kwakeham/AnalogCycleComputer/kicad/Analogue/Step/BMD-350-A-R.step

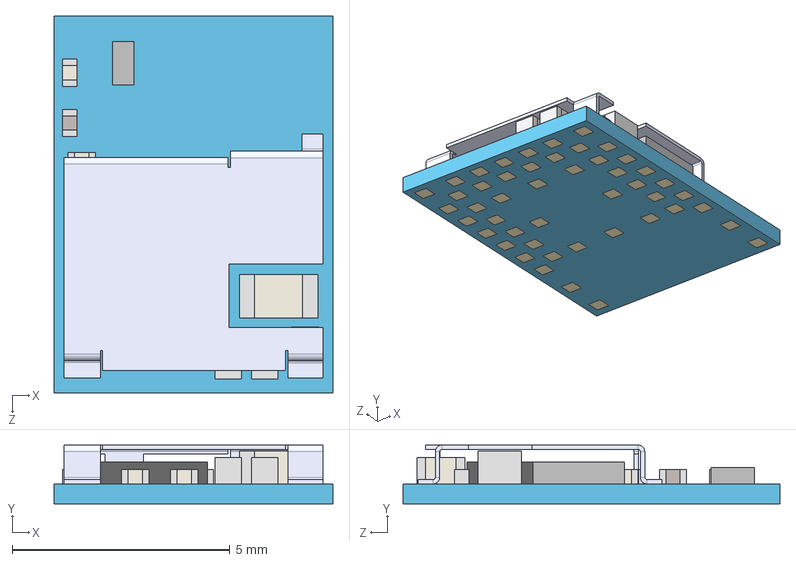
[picture p1: CAD file, 2022-01-26]
kicad/Analogue/Step/BMD-350-A-R.step
6.40 x 1.35 x 8.65 mm
BMD-350-A-R board
BMD-350 cip
