kwakeham/AnalogCycleComputer/kicad/Analogue/Step/SAM_AP214.STEP

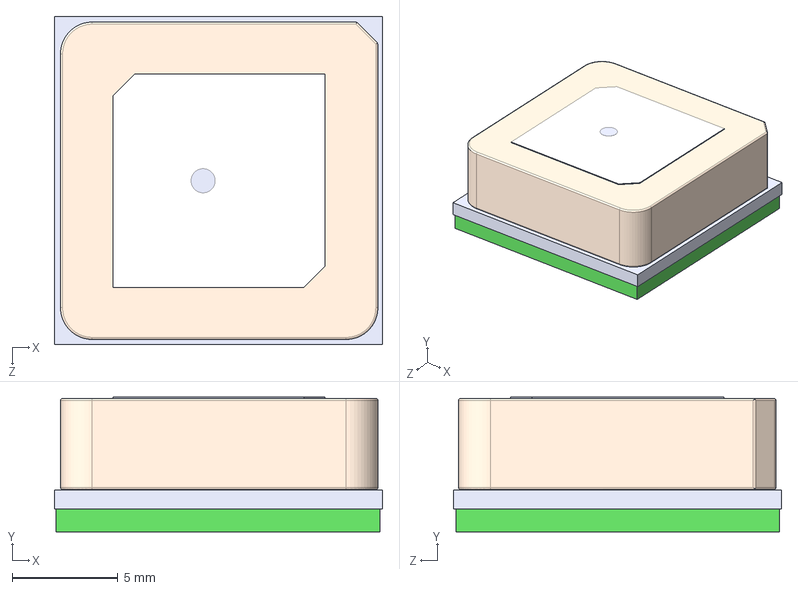
[picture p2: CAD file, 2022-01-25]
kicad/Analogue/Step/SAM_AP214.STEP
15.5 x 6.38 x 15.5 mm
Sam cavity
SAM PCB
SAM ANT
