kwakeham/AnalogCycleComputer/kicad/Analogue/Analogue.kicad_pcb

## KiCad design kicad/Analogue/Analogue.kicad_pcb (2022-01-26)

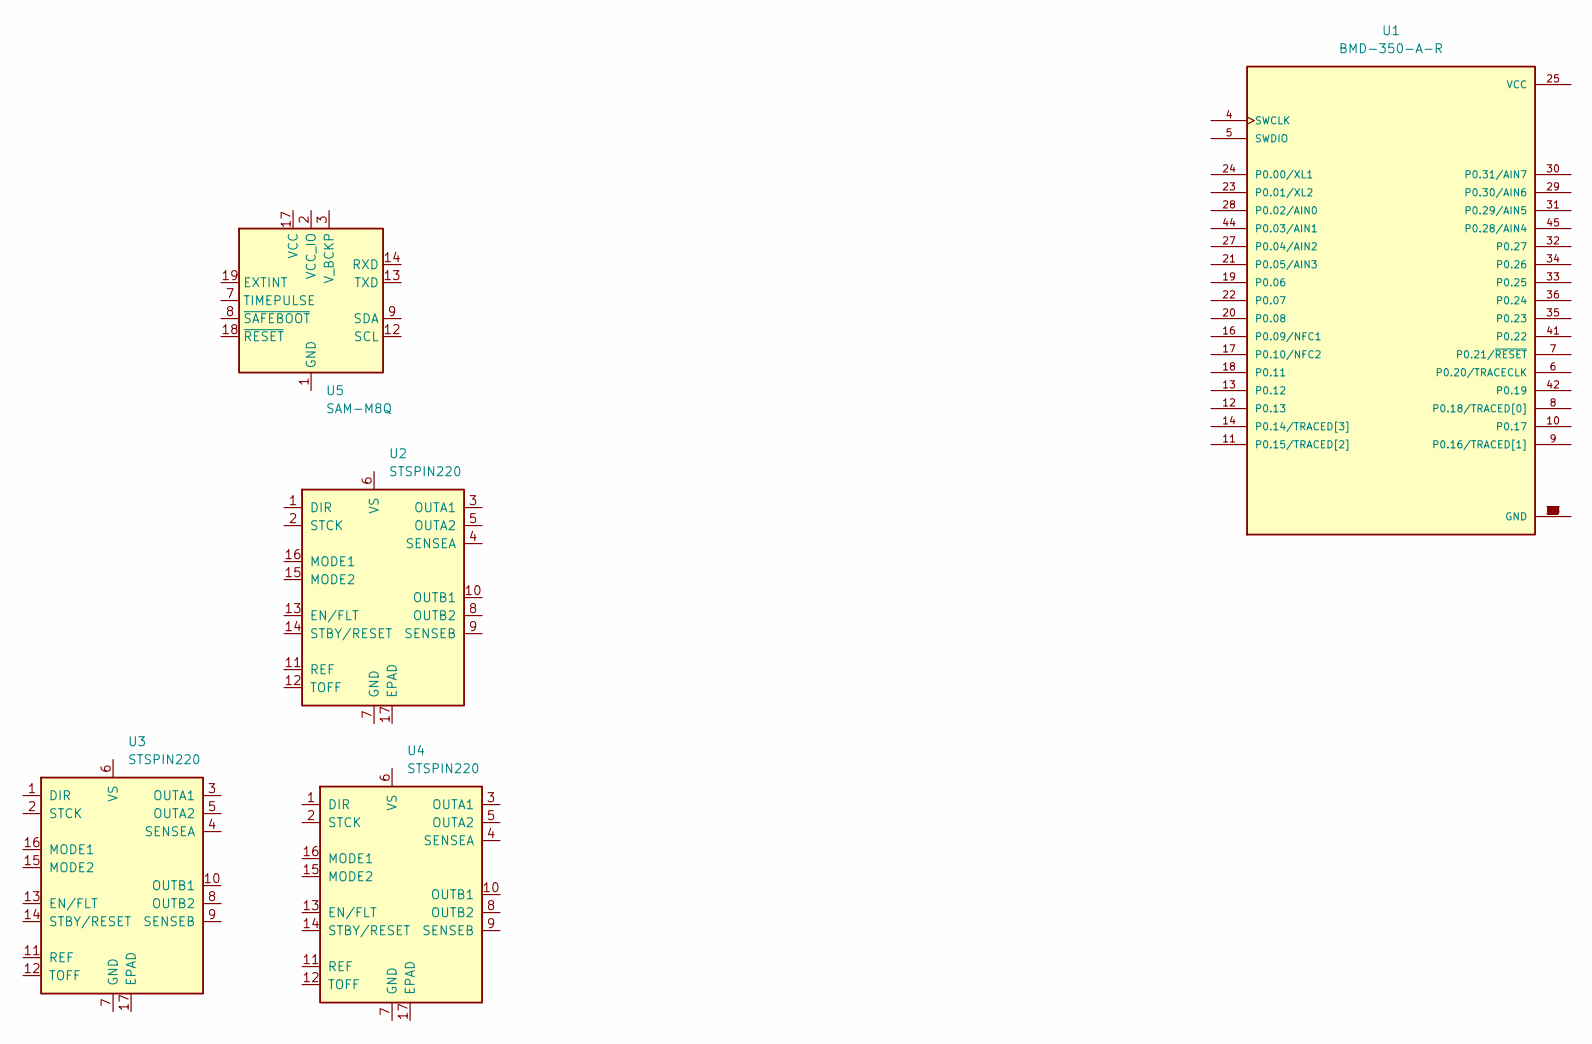
[picture p3: schematic Analogue.kicad_sch]

Parts:
U1: BMD-350-A-R; XCVR_BMD-350-A-R; PARTREV 2.0
U2, U3, U4: STSPIN220; VQFN-16-1EP_3x3mm_P0.5mm_EP1.8x1.8mm
U5: SAM-M8Q; ublox_SAM-M8Q

Connections:
unnamed: U1.1 (GND), U1.2 (GND), U1.3 (GND), U1.15 (GND), U1.26 (GND), U1.37 (GND), U1.38 (GND), U1.39 (GND), U1.40 (GND), U1.43 (GND), U1.46 (GND), U1.47 (GND)
unnamed: U5.1 (GND), U5.4 (GND), U5.5 (GND), U5.6 (GND), U5.10 (GND), U5.11 (GND), U5.15 (GND), U5.16 (GND), U5.20 (GND)

Board: 2 copper layers, 5 parts (0 on the bottom side), 2 nets, no tracks yet.
